iorodeo/clearprep_prototype/enclosure/cnc/tube_holder/tube_holder_low_array.dxf

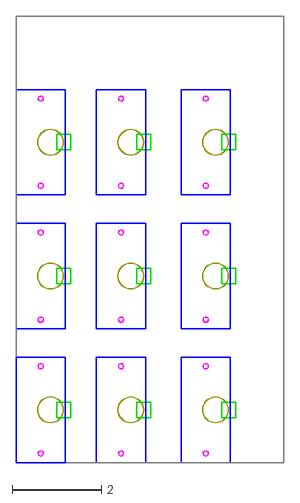
[picture p1: CAD file, 2014-09-01]
enclosure/cnc/tube_holder/tube_holder_low_array.dxf
6.00 x 10.0
