iorodeo/clearprep_prototype/enclosure/cnc/tube_holder/tube_holder_low.dxf

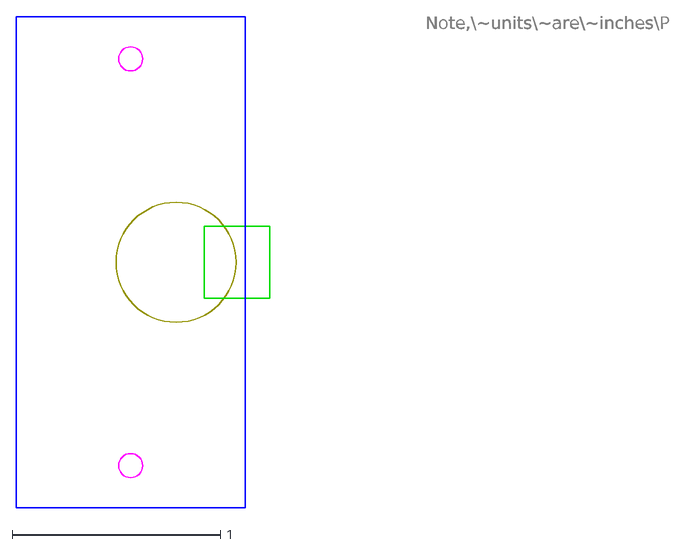
[picture p2: CAD file, 2014-09-01]
enclosure/cnc/tube_holder/tube_holder_low.dxf
Note,\~units\~are\~inches\P
