iorodeo/clearprep_prototype/enclosure/cnc/tube_holder/tube_holder_low_orig.dxf

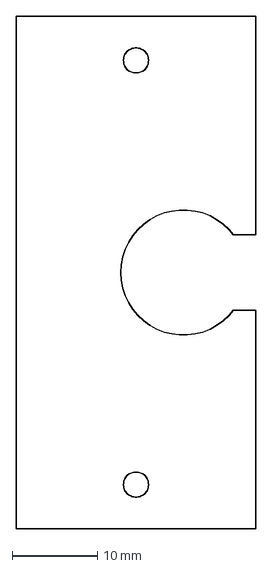
[picture p3: CAD file, 2014-09-01]
enclosure/cnc/tube_holder/tube_holder_low_orig.dxf
28.0 x 60.0 mm
