iorodeo/clearprep_prototype/enclosure/slots_5x2_up0p5/projection_top.dxf

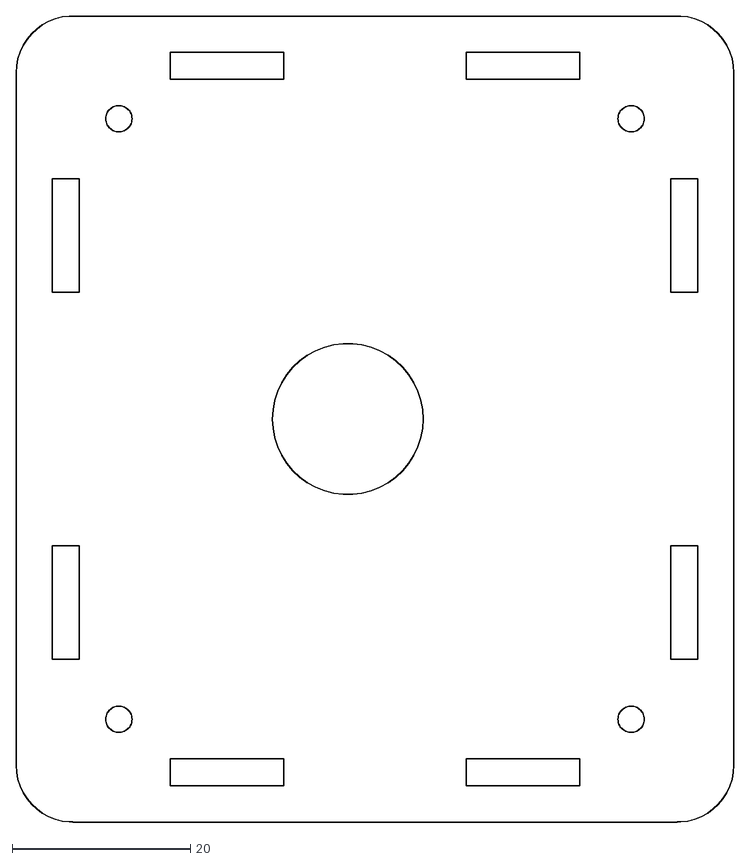
[picture p4: CAD file, 2013-02-22]
enclosure/slots_5x2_up0p5/projection_top.dxf
80.4 x 90.3
