iorodeo/clearprep_prototype/enclosure/cnc/tube_holder/projection_holder_low.dxf

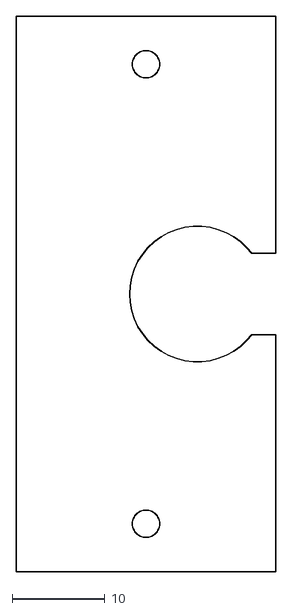
[picture p5: CAD file, 2012-09-14]
enclosure/cnc/tube_holder/projection_holder_low.dxf
28.0 x 60.0
