iorodeo/clearprep_prototype/enclosure/slots_5x2_up0p0/projection_front.dxf

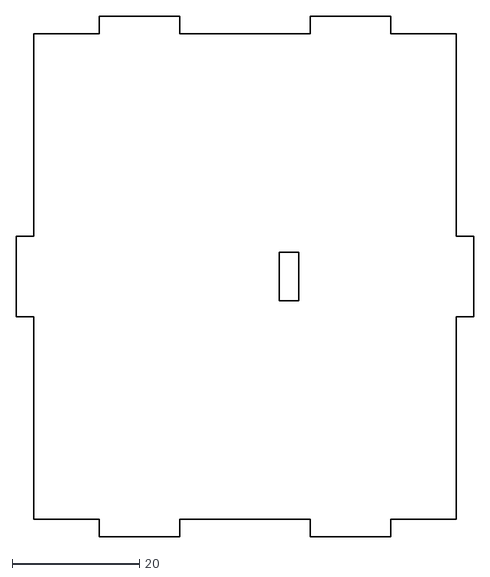
[picture p6: CAD file, 2012-09-14]
enclosure/slots_5x2_up0p0/projection_front.dxf
71.8 x 81.7
