iorodeo/clearprep_prototype/enclosure/slots_5x2_up0p5/projection_ref_cube.dxf

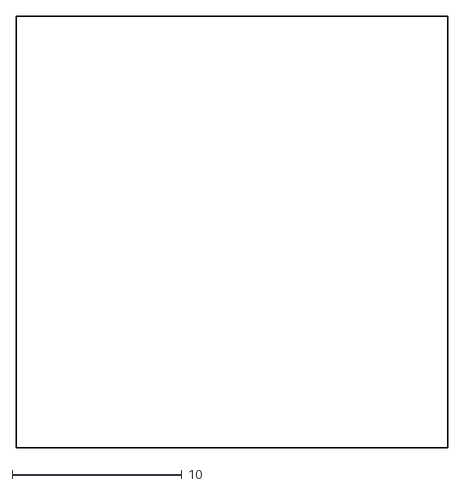
[picture p7: CAD file, 2012-09-14]
enclosure/slots_5x2_up0p5/projection_ref_cube.dxf
25.4 x 25.4
