iorodeo/clearprep_prototype/enclosure/height_2p5in/projection_holder_mid.dxf

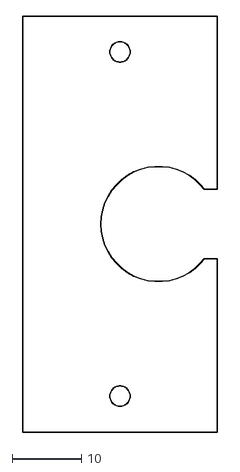
[picture p8: CAD file, 2012-09-14]
enclosure/height_2p5in/projection_holder_mid.dxf
28.0 x 60.0
