iorodeo/clearprep_prototype/enclosure/slots_5x2_up0p0/projection_second_top.dxf

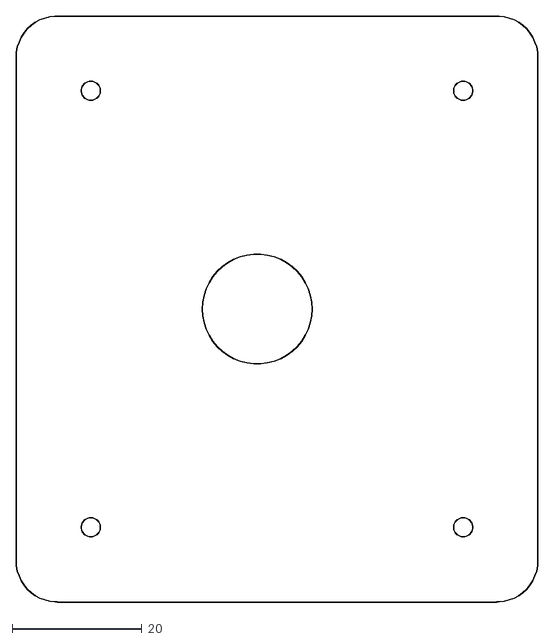
[picture p9: CAD file, 2012-09-14]
enclosure/slots_5x2_up0p0/projection_second_top.dxf
80.4 x 90.3
