iorodeo/clearprep_prototype/enclosure/height_2p5in/projection_top.dxf

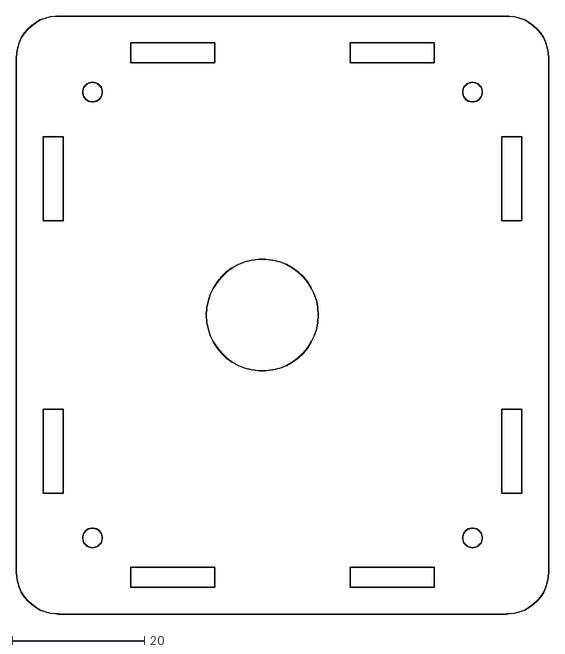
[picture p10: CAD file, 2012-09-14]
enclosure/height_2p5in/projection_top.dxf
80.4 x 90.3
