iorodeo/clearprep_prototype/enclosure/slots_5x2_up0p5/projection_bottom.dxf

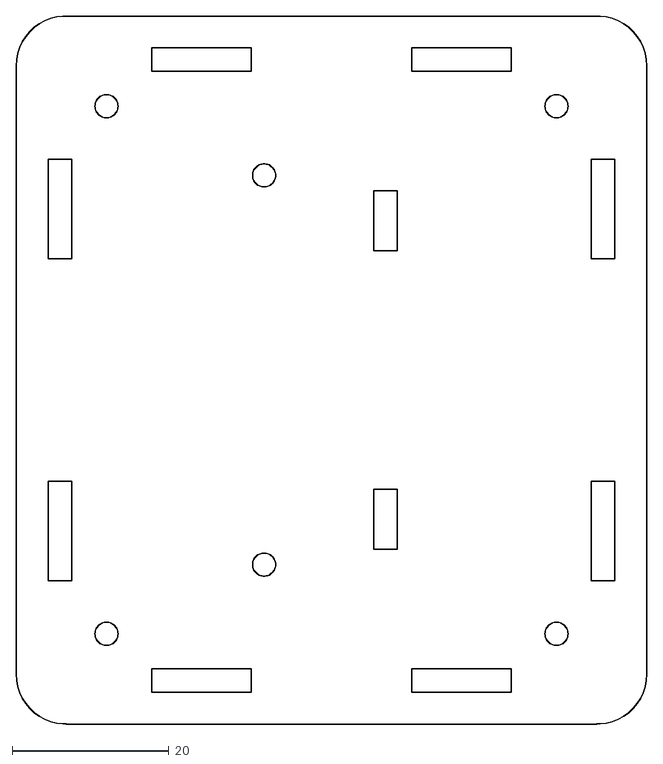
[picture p11: CAD file, 2012-09-14]
enclosure/slots_5x2_up0p5/projection_bottom.dxf
80.4 x 90.3
