iorodeo/clearprep_prototype/(list of files, cad)

Other CAD files:
aluminum_enclosure/freecad_components/lcd_plate.fcstd
enclosure/dxf/v0p1/projection_right.dxf
enclosure/dxf/v0p2/projection_inner_panel.dxf
enclosure/height_2p5in/projection_front.dxf
enclosure/slots_5x2_up0p0/projection_inner_panel.dxf
enclosure/slots_5x2_up0p5/projection_inner_panel.dxf
aluminum_enclosure/freecad_components/top_plate.fcstd
enclosure/dxf/v0p1/projection_back.dxf
enclosure/dxf/v0p2/projection_left.dxf
enclosure/height_2p5in/projection_inner_panel.dxf
enclosure/slots_5x2_up0p0/projection_left.dxf
enclosure/slots_5x2_up0p5/projection_right.dxf
enclosure/dxf/v0p1/projection_top.dxf
enclosure/dxf/v0p2/projection_right.dxf
enclosure/height_2p5in/projection_back.dxf
enclosure/slots_5x2_up0p0/projection_right.dxf
enclosure/dxf/v0p1/projection_inner_panel.dxf
enclosure/dxf/v0p2/projection_bottom.dxf
enclosure/height_2p5in/projection_right.dxf
enclosure/slots_5x2_up0p5/projection_left.dxf
enclosure/dxf/v0p1/projection_front.dxf
enclosure/height_2p5in/projection_left.dxf
enclosure/dxf/v0p1/projection_second_top.dxf
enclosure/dxf/v0p1/projection_holder_low.dxf
enclosure/dxf/v0p1/projection_left.dxf
enclosure/dxf/v0p1/projection_bottom.dxf
enclosure/dxf/v0p1/projection_holder_mid.dxf
aluminum_enclosure/freecad_components/top_plate.dxf
enclosure/old/modified_slots/slot_3p87x3p87.dxf
enclosure/old/modified_slots/slot_5x3.dxf
enclosure/old/slots_5x2_up0p0/projection_inner_panel.dxf
enclosure/old/slots_5x2_up0p0/projection_left.dxf
enclosure/old/slots_5x2_up0p0/projection_right.dxf
enclosure/old/slots_5x2_up0p5/projection_inner_panel.dxf
enclosure/old/slots_5x2_up0p5/projection_left.dxf
enclosure/old/slots_5x2_up0p5/projection_right.dxf
