iorodeo/clearprep_prototype/enclosure/dxf/v0p2/3mm_black.pdf

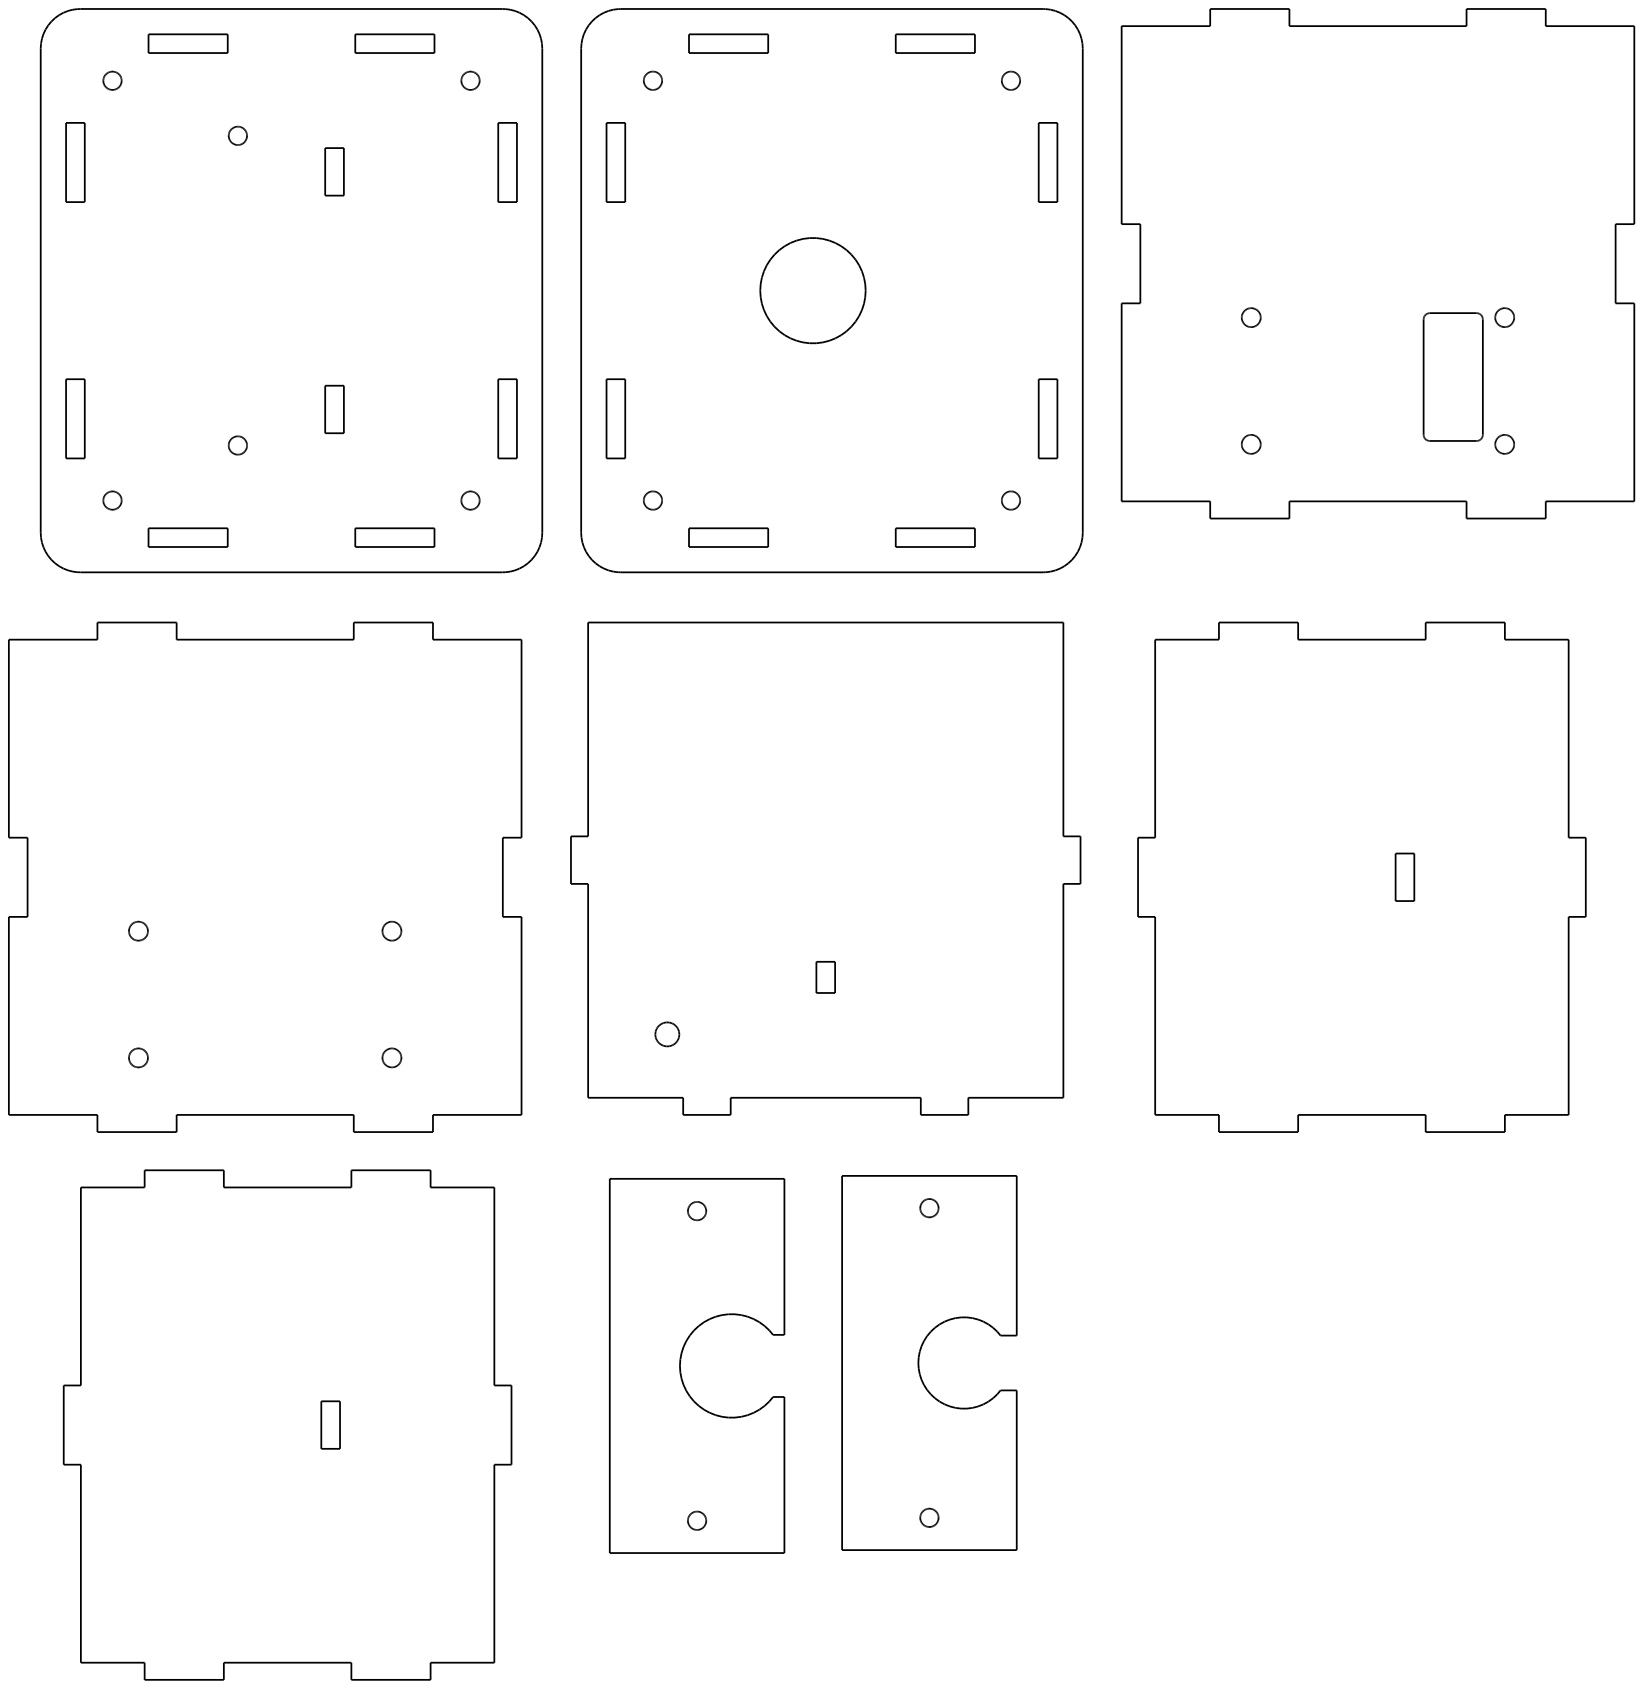
[picture p12: page 1]
