iorodeo/clearprep_prototype/enclosure/dxf/v0p1/3mm_black.pdf

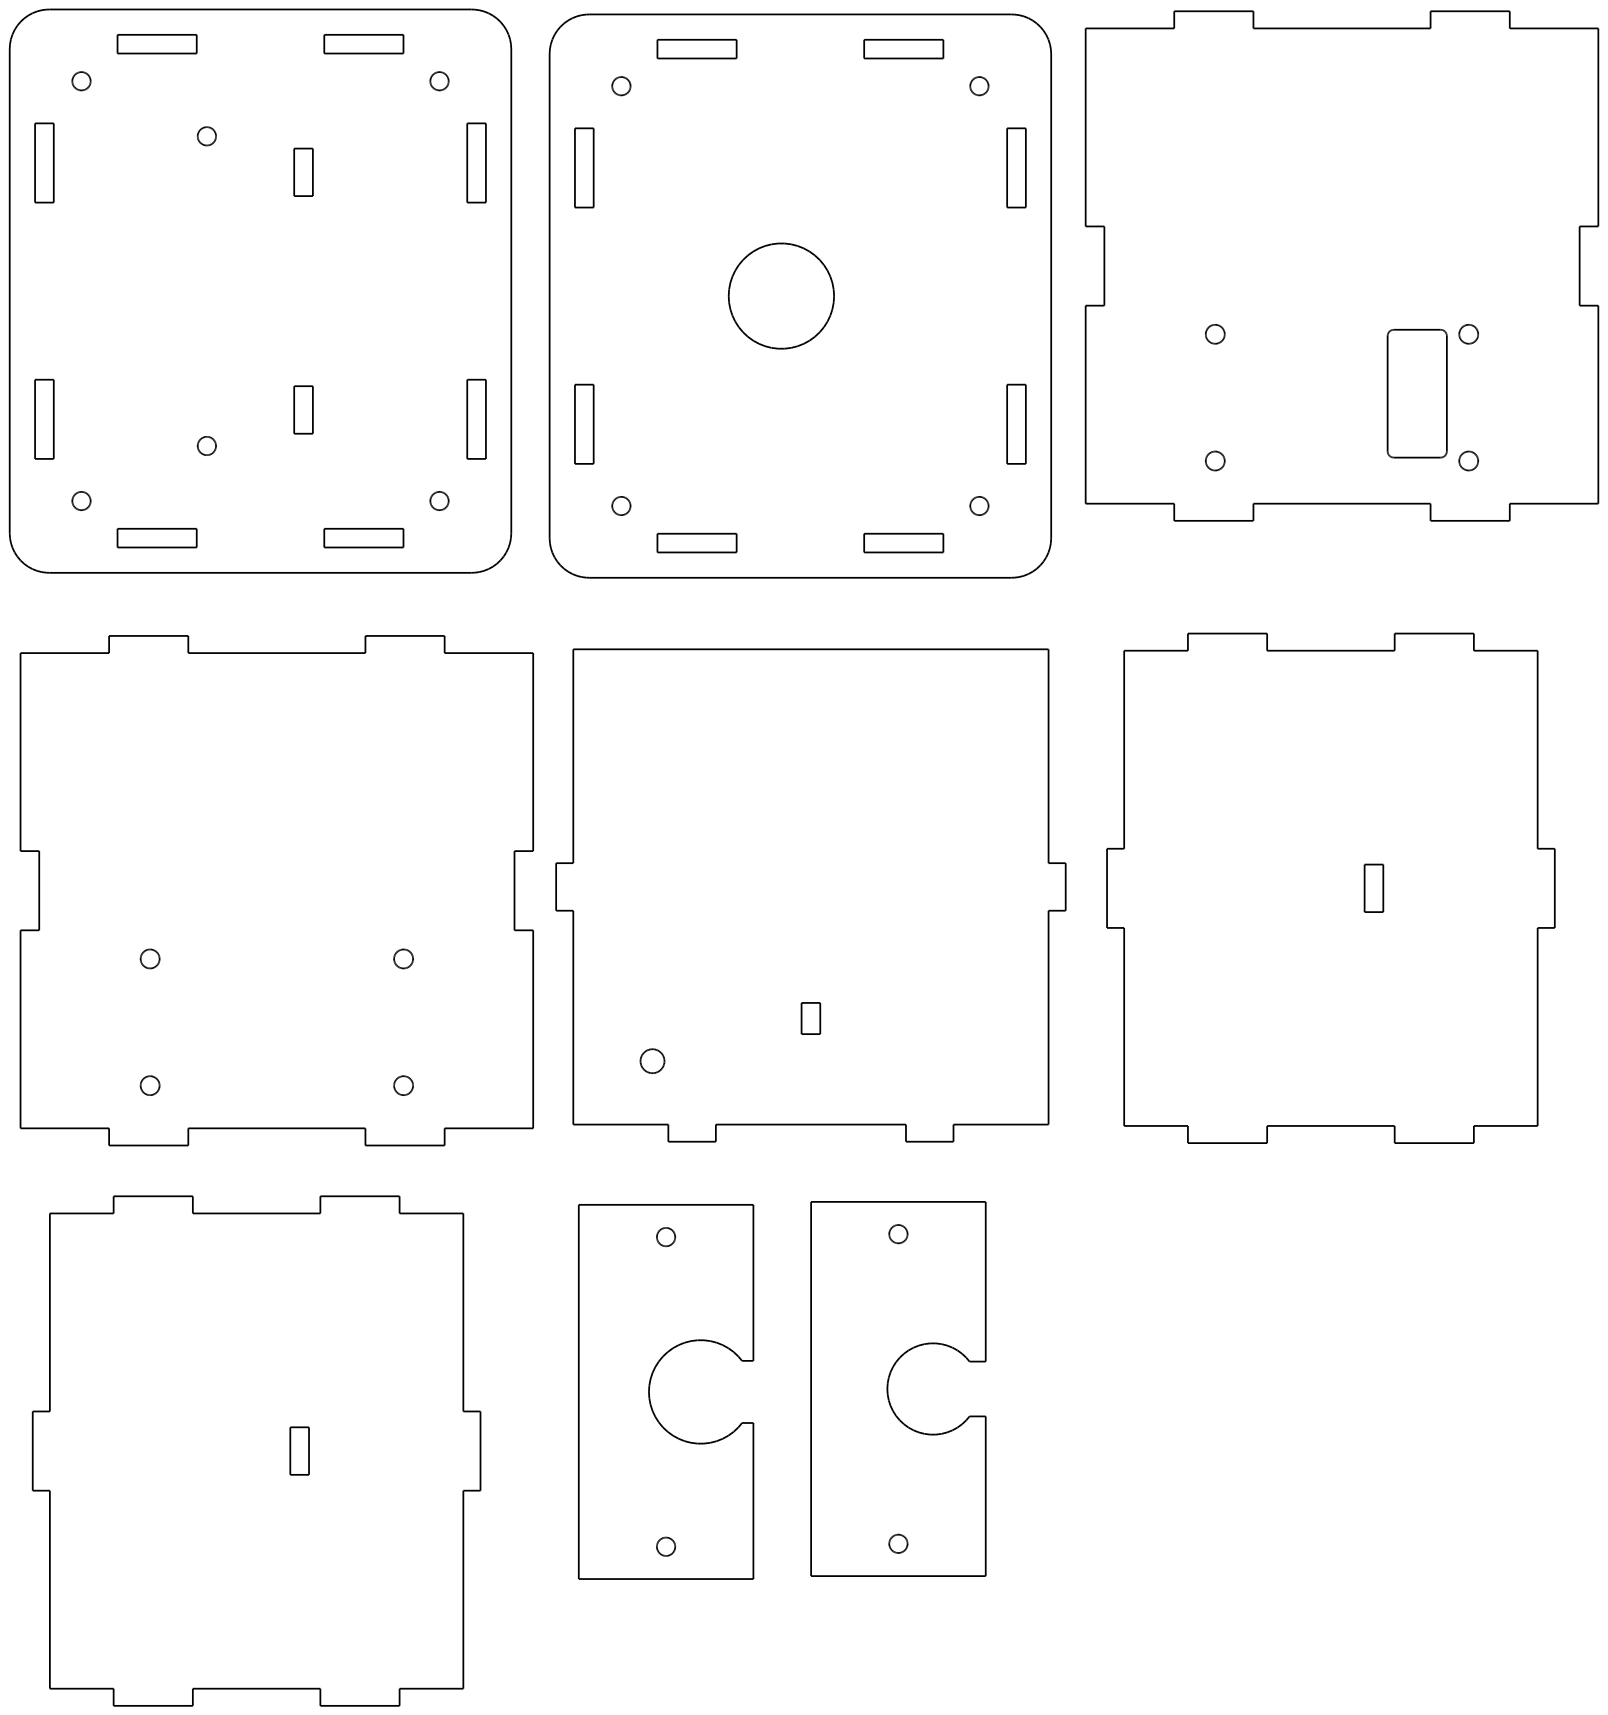
[picture p13: page 1]
