iorodeo/clearprep_prototype/(list of files, drawings)

Other design files:
clearprep_shield/colorimeter_shield.dsn
