iorodeo/clearprep_prototype/clearprep_shield/colorimeter_shield.sch

## KiCad design clearprep_shield/colorimeter_shield.sch (2013-06-12)

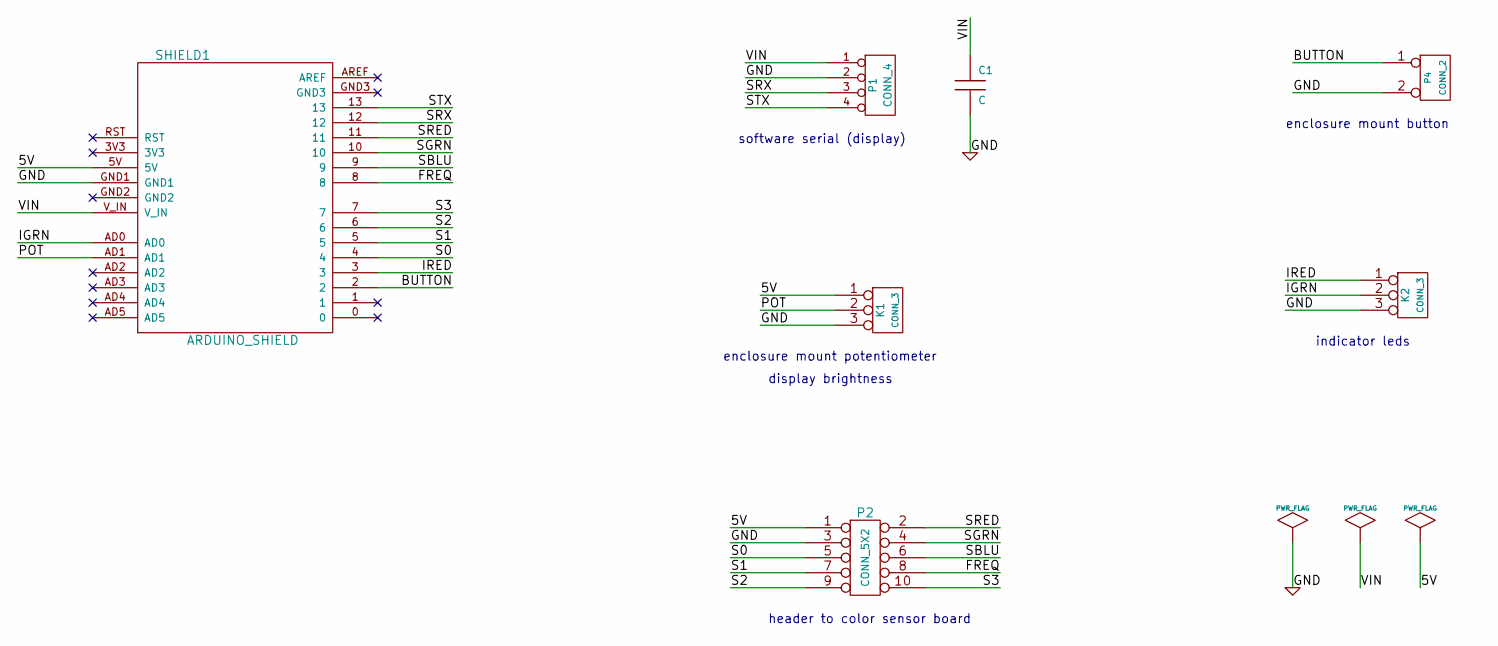
[picture p14: schematic colorimeter_shield.sch]

Parts:
C1: C
K1, K2: CONN_3
P1: CONN_4
P2: CONN_5X2
P4: CONN_2
SHIELD1: ARDUINO_SHIELD

Connections:
5V: K1.1, P2.1, SHIELD1.5V
BUTTON: P4.1, SHIELD1.2
FREQ: P2.8, SHIELD1.8
GND: C1.2, K1.3, K2.3, P1.2, P2.3, P4.2 (PM), SHIELD1.GND1
IGRN: K2.2 (PM), SHIELD1.AD0
IRED: K2.1, SHIELD1.3
POT: K1.2 (PM), SHIELD1.AD1
S0: P2.5, SHIELD1.4
S1: P2.7, SHIELD1.5
S2: P2.9, SHIELD1.6
S3: P2.10, SHIELD1.7
SBLU: P2.6, SHIELD1.9
SGRN: P2.4, SHIELD1.10
SRED: P2.2, SHIELD1.11
SRX: P1.3, SHIELD1.12
STX: P1.4, SHIELD1.13
VIN: C1.1, P1.1, SHIELD1.V_IN

Notes on the sheet:
display brightness
enclosure mount potentiometer
enclosure mount button
header to color sensor board
software serial (display)
indicator leds
