iorodeo/clearprep_prototype/firmware_v0p2/firmware/firmware.ino

#define __STDC_LIMIT_MACROS
#include <stdint.h>
#include <SoftwareSerial.h>
#include <EEPROM.h>
#include "SerialLCD.h"
#include "Streaming.h"

#include "constants.h"
#include "display_handler.h"
#include "system_state.h"

SystemState sysState;

void setup()
{
    sysState.initialize();
}

void loop()
{
    sysState.update();
    delay(100);
}
