iorodeo/clearprep_prototype/firmware_v0p2/firmware/color_sensor.cpp

// ColorSensor.cpp
//
// Interface to ??? rgb color sensor
#include "color_sensor.h"

void ColorSensor::initialize(uint8_t _S0, uint8_t _S1, uint8_t _S2, uint8_t _S3, uint8_t _FO) {

    S0 = _S0;
    S1 = _S1;
    S2 = _S2;
    S3 = _S3;
    FO = _FO;

    // Set correct pin modes
    pinMode(S0, OUTPUT); 
    pinMode(S1, OUTPUT); 
    pinMode(S2, OUTPUT); 
    pinMode(S3, OUTPUT); 
    pinMode(FO, INPUT);

    // Set frequency scaling 
    digitalWrite(S0,HIGH);
    //digitalWrite(S1,LOW);
    digitalWrite(S1,HIGH);

    timeoutCountMax = DFLT_TIMEOUT_COUNT_MAX;
    pulseInWait = DFLT_PULSE_IN_WAIT;
}

uint32_t ColorSensor::getFrequency(uint16_t numSamples) {
    uint32_t dt;
    uint32_t freq = 0;
    uint16_t _numSamples = numSamples;
    uint16_t timeoutCount = 0;

    for(uint16_t j=0; j<numSamples; j++) {
        dt = pulseIn(FO, HIGH, pulseInWait);
        if (dt > 0) {
            freq+= 500000/dt;
        }
        else {
            _numSamples -= 1;
            timeoutCount += 1;
        }
        if (timeoutCount > timeoutCountMax) {
            freq = 0;
            _numSamples = 1;
            break;
        }
    }
    return freq/_numSamples;
}

void ColorSensor::setChannelBlue() {
    digitalWrite(S2,LOW);
    digitalWrite(S3,HIGH);
}

void ColorSensor::setChannelGreen() {
    digitalWrite(S2,HIGH);
    digitalWrite(S3,HIGH);
}

void ColorSensor::setChannelRed() {
    digitalWrite(S2,LOW);
    digitalWrite(S3,LOW);
}

void ColorSensor::setChannelClear() {
    digitalWrite(S2,HIGH);
    digitalWrite(S3,LOW);
}
