iorodeo/clearprep_prototype/serialGLCD/firmware/aux_font.h

static char aux_text_array[1903] PROGMEM = {0x0a, 0x10, 0x01,
0x00, 0x00, 0x00, 0x00, 0x00, 0x00, 0x00, 0x00, 0x00, 0x00, 0x00, 0x00, 0x00, 0x00, 0x00, 0x00, 0x00, 0x00, 0x00, 0x00
, 0x00, 0x00, 0x00, 0x00, 0xff, 0xff, 0x00, 0x00, 0x00, 0x00, 0x00, 0x00, 0x00, 0x00, 0x0c, 0x0c, 0x00, 0x00, 0x00, 0x00
, 0x00, 0x00, 0x0f, 0x0f, 0x00, 0x00, 0x0f, 0x0f, 0x00, 0x00, 0x00, 0x00, 0x00, 0x00, 0x00, 0x00, 0x00, 0x00, 0x00, 0x00
, 0x80, 0x98, 0xd8, 0xfc, 0x9f, 0x99, 0xf8, 0xff, 0x9f, 0x18, 0x01, 0x0d, 0x0f, 0x01, 0x01, 0x0f, 0x07, 0x01, 0x01, 0x00
, 0x00, 0x38, 0x7c, 0x6c, 0xff, 0xcc, 0xcc, 0x80, 0x00, 0x00, 0x00, 0x06, 0x0c, 0x0c, 0x3f, 0x0c, 0x0f, 0x07, 0x00, 0x00
, 0x8e, 0x91, 0x51, 0x51, 0x4e, 0xa0, 0xa0, 0x90, 0x10, 0x00, 0x00, 0x00, 0x00, 0x00, 0x07, 0x08, 0x08, 0x08, 0x07, 0x00
, 0x00, 0x80, 0xee, 0x3f, 0x73, 0xe3, 0xc3, 0x06, 0xc0, 0xc0, 0x00, 0x03, 0x07, 0x0e, 0x0c, 0x0c, 0x0f, 0x0f, 0x0f, 0x09
, 0x00, 0x00, 0x00, 0x00, 0x0f, 0x0f, 0x00, 0x00, 0x00, 0x00, 0x00, 0x00, 0x00, 0x00, 0x00, 0x00, 0x00, 0x00, 0x00, 0x00
, 0x00, 0x00, 0x00, 0xf0, 0xfe, 0x0f, 0x01, 0x00, 0x00, 0x00, 0x00, 0x00, 0x00, 0x03, 0x1f, 0x3c, 0x20, 0x00, 0x00, 0x00
, 0x00, 0x00, 0x01, 0x0f, 0xfe, 0xf0, 0x00, 0x00, 0x00, 0x00, 0x00, 0x00, 0x20, 0x3c, 0x1f, 0x03, 0x00, 0x00, 0x00, 0x00
, 0x00, 0x24, 0x3c, 0x18, 0xff, 0x18, 0x3c, 0x24, 0x00, 0x00, 0x00, 0x00, 0x00, 0x00, 0x00, 0x00, 0x00, 0x00, 0x00, 0x00
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
, 0x00, 0xff, 0xff, 0x63, 0x63, 0x63, 0x63, 0x63, 0x03, 0x00, 0x00, 0x0f, 0x0f, 0x00, 0x00, 0x00, 0x00, 0x00, 0x00, 0x00
, 0x00, 0xf8, 0xfe, 0x06, 0x03, 0xc3, 0xc3, 0xc3, 0xc6, 0x00, 0x00, 0x01, 0x07, 0x06, 0x0c, 0x0c, 0x0c, 0x0f, 0x07, 0x00
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
};
