iorodeo/clearprep_prototype/(commit log)

2012-09-14 Added enclosure design.
    [projection_back.dxf, projection_bottom.dxf, projection_front.dxf, projection_holder_low.dxf, projection_holder_mid.dxf, projection_inner_panel.dxf, projection_left.dxf, projection_ref_cube.dxf]
2013-02-22 Changes to dxf files.
    [projection_inner_panel.dxf, projection_left.dxf, projection_right.dxf]
2013-02-22 Added new Al enclosure design. Added prototyping designs. Modified enclosure ht.
    [projection_back.dxf, projection_bottom.dxf, projection_front.dxf, projection_holder_low.dxf, projection_holder_mid.dxf, projection_inner_panel.dxf, projection_left.dxf, projection_ref_cube.dxf]
2013-03-03 Addd freecad designs for laser top and lcd plates.
    [lcd_plate.fcstd, top_plate.dxf, top_plate.fcstd]
2013-06-12 Added arduino sheild.
    [$savepcb.brd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]
2013-06-12 Designed ardiuno sheild for clearprep device.
    [$colorimeter_shield.sch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]
2013-07-23 Modified firmware so that threshold is displayed in measurement mode and so that there are only two modes: measurement and set threhold.
    [colorimeter_shield.brd, colorimeter_shield.sch]
2013-09-12 Fixed issue which was causing measurement to fluctuate to an unacceptable level.
    [constants.cpp, constants.h, system_state.cpp]
2013-10-01 Fixed issue with aluminum enclosure design.
2013-12-29 Removed unnecessary file.
    [$colorimeter_shield.sch]
2014-09-01 Moved to cruft. Started work on cnc for tube holder.
    [projection_back.dxf, projection_bottom.dxf, projection_front.dxf, projection_holder_low.dxf, projection_holder_mid.dxf, projection_inner_panel.dxf, projection_left.dxf, projection_ref_cube.dxf]
2014-09-01 Added tube holder cnc router cam.
    [tube_holder_low.dxf, tube_holder_low_orig.dxf]
2014-09-01 Added array and machining operations notes.
    [tube_holder_low_array.dxf]
